EnzoCordovil/Controle-nivel-arduino/docs/GEOMETRIA_E_CONEXOES.md

# Geometria de exemplo e conexões elétricas

[English](en/GEOMETRY_AND_WIRING.md) | [Português](GEOMETRIA_E_CONEXOES.md)

As dimensões deste exemplo foram escolhidas para os cálculos e o desenho do conjunto. As pranchas estão disponíveis em PNG e SVG, com aparência de desenho CAD. Os arquivos são ilustrações técnicas, sem modelo DWG ou detalhamento de fabricação.

## Vista 3D

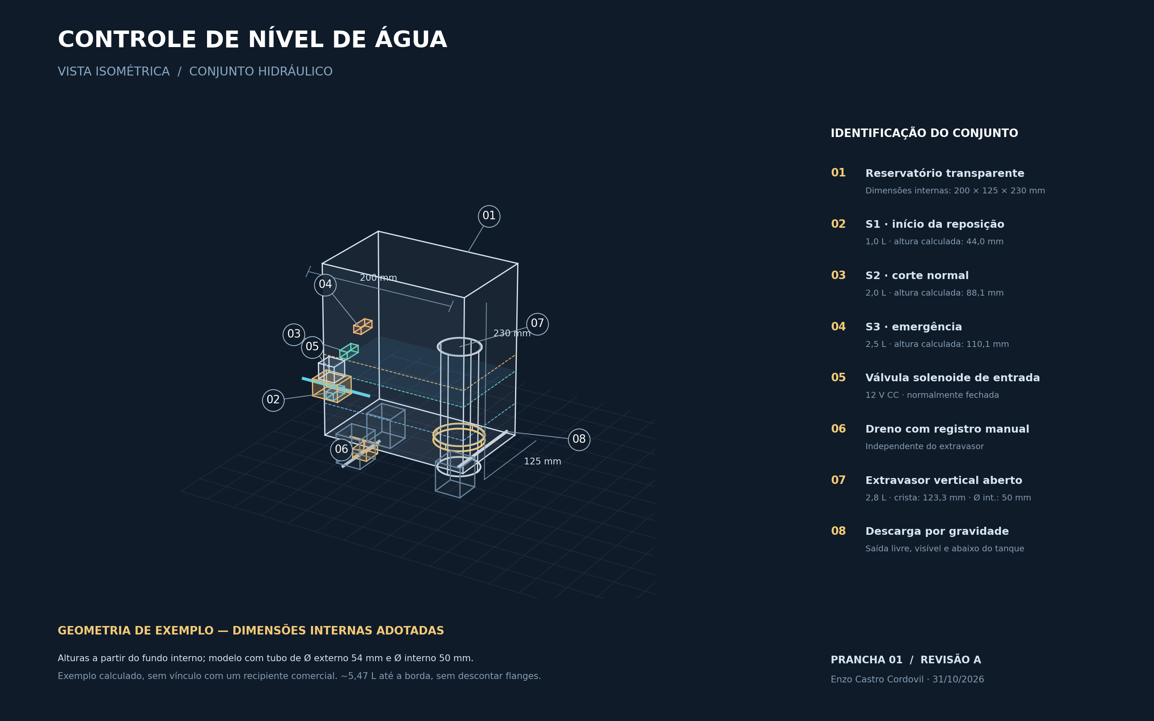
[picture p3: docs/Vista_3D_Conceitual.png]
Conjunto hidráulico


[Abrir vista 3D em tamanho original](https://github.com/EnzoCastro-neko/controle-nivel-agua-arduino/raw/refs/heads/main/docs/Vista_3D_Conceitual.png)

O tanque é aberto e ventilado, com dimensões internas de 200 × 125 × 230 mm. As paredes devem ser planas, feitas de material não metálico compatível com água e com espessura que permita a detecção pelo sensor, cujo alcance é de 3 mm. A resistência da parede precisa de dimensionamento próprio: atender ao alcance do sensor não garante suporte à carga de água.

O tubo extravasor tem 50 mm de diâmetro interno e 54 mm de diâmetro externo no exemplo. Confira essas duas medidas ao escolher uma bitola comercial. A borda superior é horizontal e aberta; a descarga passa por uma conexão estanque no fundo e termina livre, abaixo do tanque. Reserve espaço para flanges, suportes e curvas.

Área interna: `A = 0,200 × 0,125 = 0,025 m²`.

Área ocupada pelo tubo abaixo da crista: `At = π × 0,054² / 4 = 0,002290221 m²`.

Até 2,8 L: `h = V / (A − At)`. Acima da crista: `h = h_crista + (V − 0,0028) / A`. O interior do tubo permanece drenado no cálculo estático; o deslocamento usa o diâmetro externo, incluindo esse espaço que não armazena água no reservatório.

| Função | Volume | Altura acima do fundo interno |
|---|---:|---:|
| S1 — inferior | 1,0 L | 44,0 mm |
| S2 — superior | 2,0 L | 88,1 mm |
| S3 — emergência | 2,5 L | 110,1 mm |
| Crista do extravasor | 2,8 L | 123,3 mm |
| Limite conservador de cálculo | 5,0 L | 211,3 mm |
| Borda geométrica | ~5,47 L | 230,0 mm |

As alturas indicam o ponto de detecção dos sensores, que ficam por fora do tanque. S2 e S3 podem ser deslocados horizontalmente para que os corpos não se sobreponham; confira também a interferência com o tubo. A borda do extravasor fica acima de S3. As posições laterais da entrada, do dreno e da passagem de fundo são ilustrativas e não definem um gabarito de furação.

O volume bruto é 5,75 L; o tubo desloca aproximadamente 0,282 L até a crista. A capacidade geométrica líquida resulta em 5,468 L, sem descontar flanges ou outras peças internas. A nova geometria mantém os volumes de operação e os prazos do código. Na montagem, recalibrar com água e todas as conexões instaladas.

No modelo de vertedor circular, `Q = (2/3) Cd π D √(2g) H^(3/2)`. Com 12 L/min, `Cd=0,4` e condução assumida de pelo menos 18 L/min, o equilíbrio do exemplo é aproximadamente 3,063 L. Na sensibilidade de `Cd=0,2 a 0,6`, o maior equilíbrio é 3,217 L. São previsões ideais; não demonstram capacidade de uma tubulação real ou funcionamento universal.

Execute `python3 tests/teste_geometria_exemplo.py` a partir da raiz. O teste hidráulico anterior foi preservado como análise das geometrias históricas; os ensaios dinâmicos em `tests/physical.cpp` usam agora a área interna de 0,025 m² acima da crista.

## Esquema elétrico

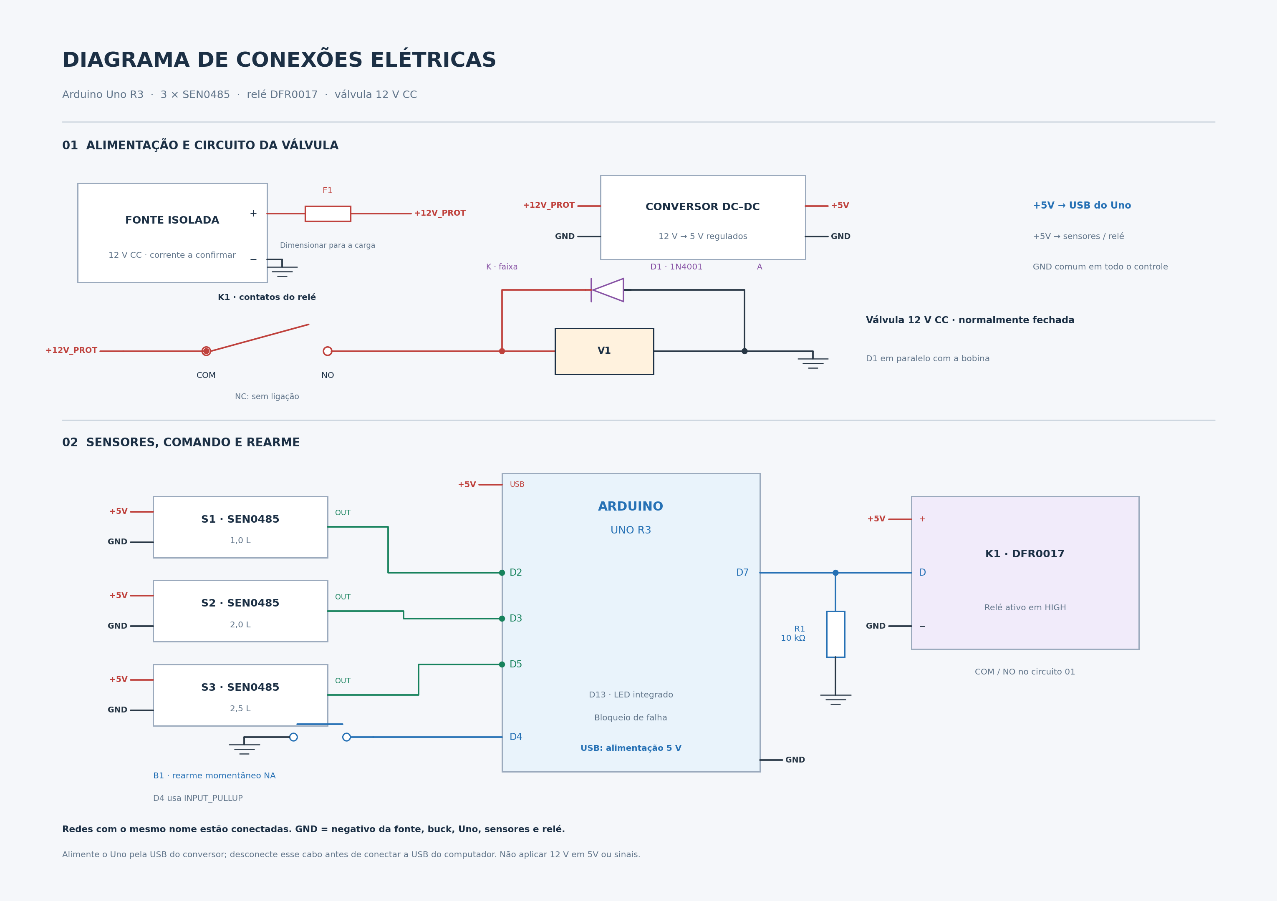
[picture p4: docs/Diagrama_Eletrico.png]
Conexões elétricas


[Abrir diagrama elétrico em tamanho original](https://github.com/EnzoCastro-neko/controle-nivel-agua-arduino/raw/refs/heads/main/docs/Diagrama_Eletrico.png)

Pontos com o mesmo rótulo de rede estão conectados. `GND` é o negativo CC comum à fonte, ao conversor, ao Arduino, aos sensores e ao módulo relé. Ele não representa o terra de proteção da rede elétrica. Para localizar os bornes, siga as identificações impressas no hardware; os blocos do desenho mostram as funções, sem reproduzir a disposição física de cada placa.

| Origem | Destino | Observação |
|---|---|---|
| Fonte +12 V | F1 → rede +12V_PROT | F1 a dimensionar conforme válvula, conversor e cabos |
| +12V_PROT | COM do relé e entrada positiva do conversor | Ramos em paralelo |
| Fonte negativa | GND comum | Inclui entrada/saída negativa do buck |
| Conversor +5 V | VCC dos três sensores, + do relé e alimentação USB do Uno | Distribuição em paralelo; corrente a dimensionar |
| Sensor S1 OUT (verde) | D2 | Inferior; ativo em LOW |
| Sensor S2 OUT (verde) | D3 | Superior; ativo em LOW |
| Sensor S3 OUT (verde) | D5 | Emergência; ativo em LOW |
| Sensores VCC (vermelho) | +5 V | Todos os sensores |
| Sensores GND (preto) | GND | Todos os sensores |
| D7 | Terminal D do módulo relé | HIGH aciona o relé de referência |
| D7 | R1 de 10 kΩ → GND | Mantém comando baixo durante a partida |
| D4 | Botão NA → GND | INPUT_PULLUP no programa |
| NO do relé | Positivo da bobina da válvula | Válvula normalmente fechada, 12 V CC |
| Negativo da bobina | GND | Retorno de potência |
| D1 cátodo (faixa) | Positivo da bobina após NO | Diodo em antiparalelo |
| D1 ânodo | Negativo da bobina | 1N4001 de referência; conferir adequação à válvula |
| NC do relé | Sem conexão | Não confundir com válvula hidráulica normalmente fechada |

O Arduino recebe 5 V regulados pela USB, com cabo e conexão apropriados. Antes de ligar a USB do computador, desconecte a alimentação que vem do conversor. Não use as duas fontes USB ao mesmo tempo nem aplique 12 V ao pino 5V, aos sinais ou à USB. Dimensione a alimentação e a proteção contra sobrecorrente conforme o hardware escolhido. O esquema começa na saída CC da fonte isolada; a entrada de rede CA fica fora do desenho.

O terceiro sensor usa o mesmo Arduino e relé e não é um circuito de segurança independente. O diagrama não elimina as limitações descritas no relatório, incluindo válvula presa, sensor inferior travado e extravasor obstruído.

## Fontes de pinagem

- [DFRobot SEN0485 — alimentação, fios e saída digital](https://wiki.dfrobot.com/sen0485).
- [DFRobot DFR0017 — terminais de controle e contatos](https://wiki.dfrobot.com/dfr0017/).

## Arquivos editáveis e reprodução

- [Vista 3D em SVG](Vista_3D_Conceitual.svg).
- [Diagrama elétrico em SVG](Diagrama_Eletrico.svg).
- `python3 docs/gerar_diagramas.py` gera as imagens com Python, NumPy e Matplotlib.

Os arquivos SVG são desenhos vetoriais. A vista é uma projeção 3D ilustrativa, sem um sólido paramétrico de CAD ou formato DWG.

## Dimensionamento do circuito

Os valores e as condições de seleção da fonte, conversor, válvula, fios e F1 estão em [DIMENSIONAMENTO_ELETRICO.md](DIMENSIONAMENTO_ELETRICO.md).
