EnzoCordovil/Controle-nivel-arduino/docs/Desenho_Conceitual_Controle_Nivel.png

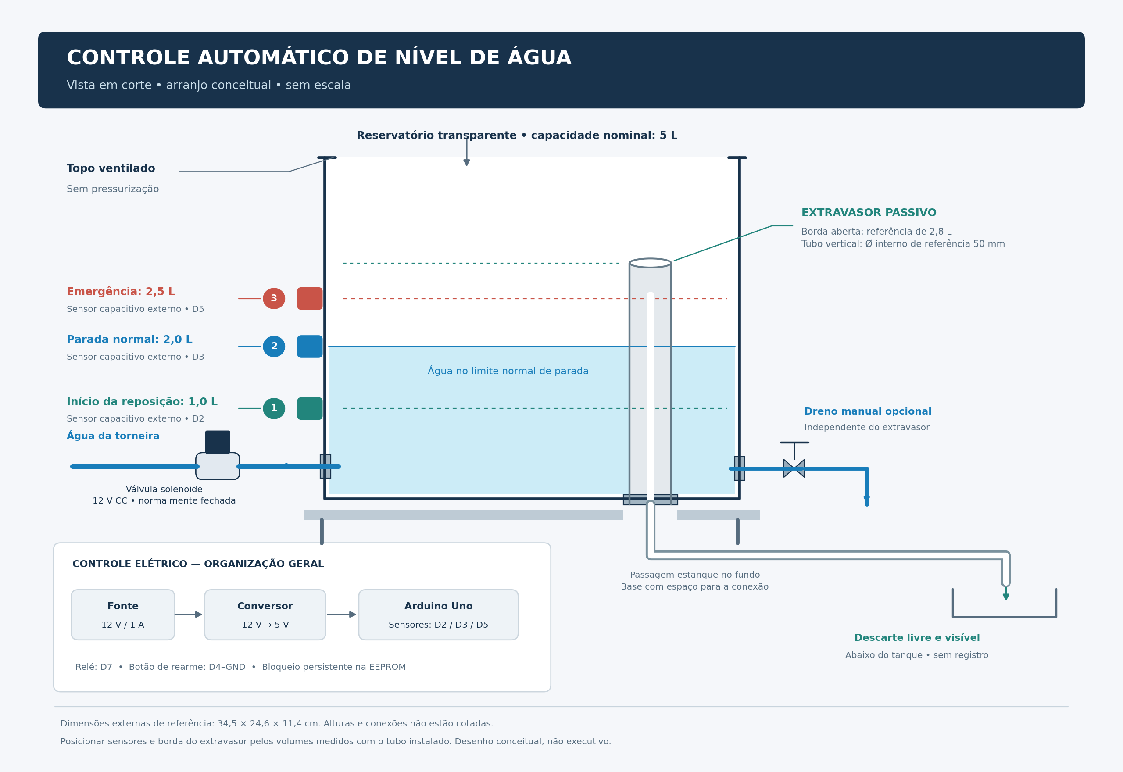
docs/Desenho_Conceitual_Controle_Nivel.png
