EnzoCordovil/Controle-nivel-arduino/(commit log)

2026-10-31 Adiciona prototipo de controle de nivel, documentacao e simulacoes
2026-10-31 Adiciona vista 3D, esquema eletrico e geometria de exemplo calculada
2026-10-31 Apresenta o sistema como projeto de controle de nivel e destaca dimensionamento
2026-10-31 Revisa escrita da documentacao e adiciona links para imagens em tamanho original
2026-10-31 Preserva README em portugues e adiciona navegacao de idioma
2026-10-31 docs: frame project scope and results for engineering portfolio
